GadgetReboot/Super_Mini_Mega_Tester/README.md

# Super_Mini_Mega_Tester
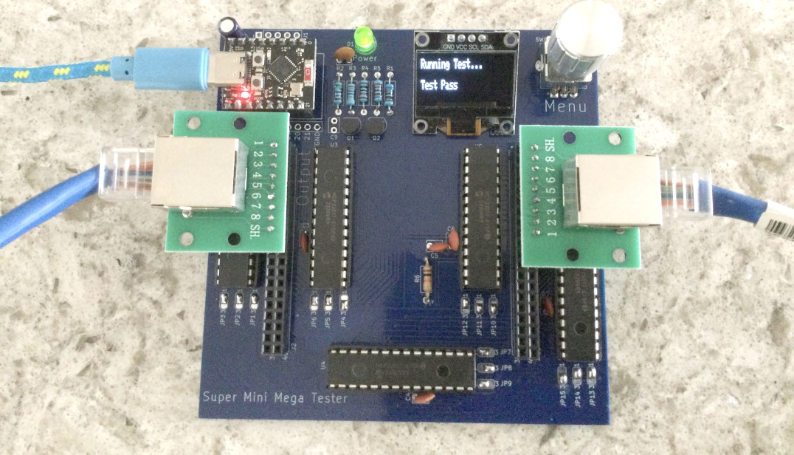
[picture p1: Assembled_PCB.jpg]
PCB
<br><br><BR><BR>
40 Pin Cable Tester platform using ESP32-C3 Super Mini module<BR><BR>
JP1 through JP15 jumpers must have solder jumpers blobbed on to set the addresses of the five GPIO expander ICs.
