GadgetReboot/Super_Mini_Mega_Tester/Sch_Super_Mini_Mega Tester.pdf

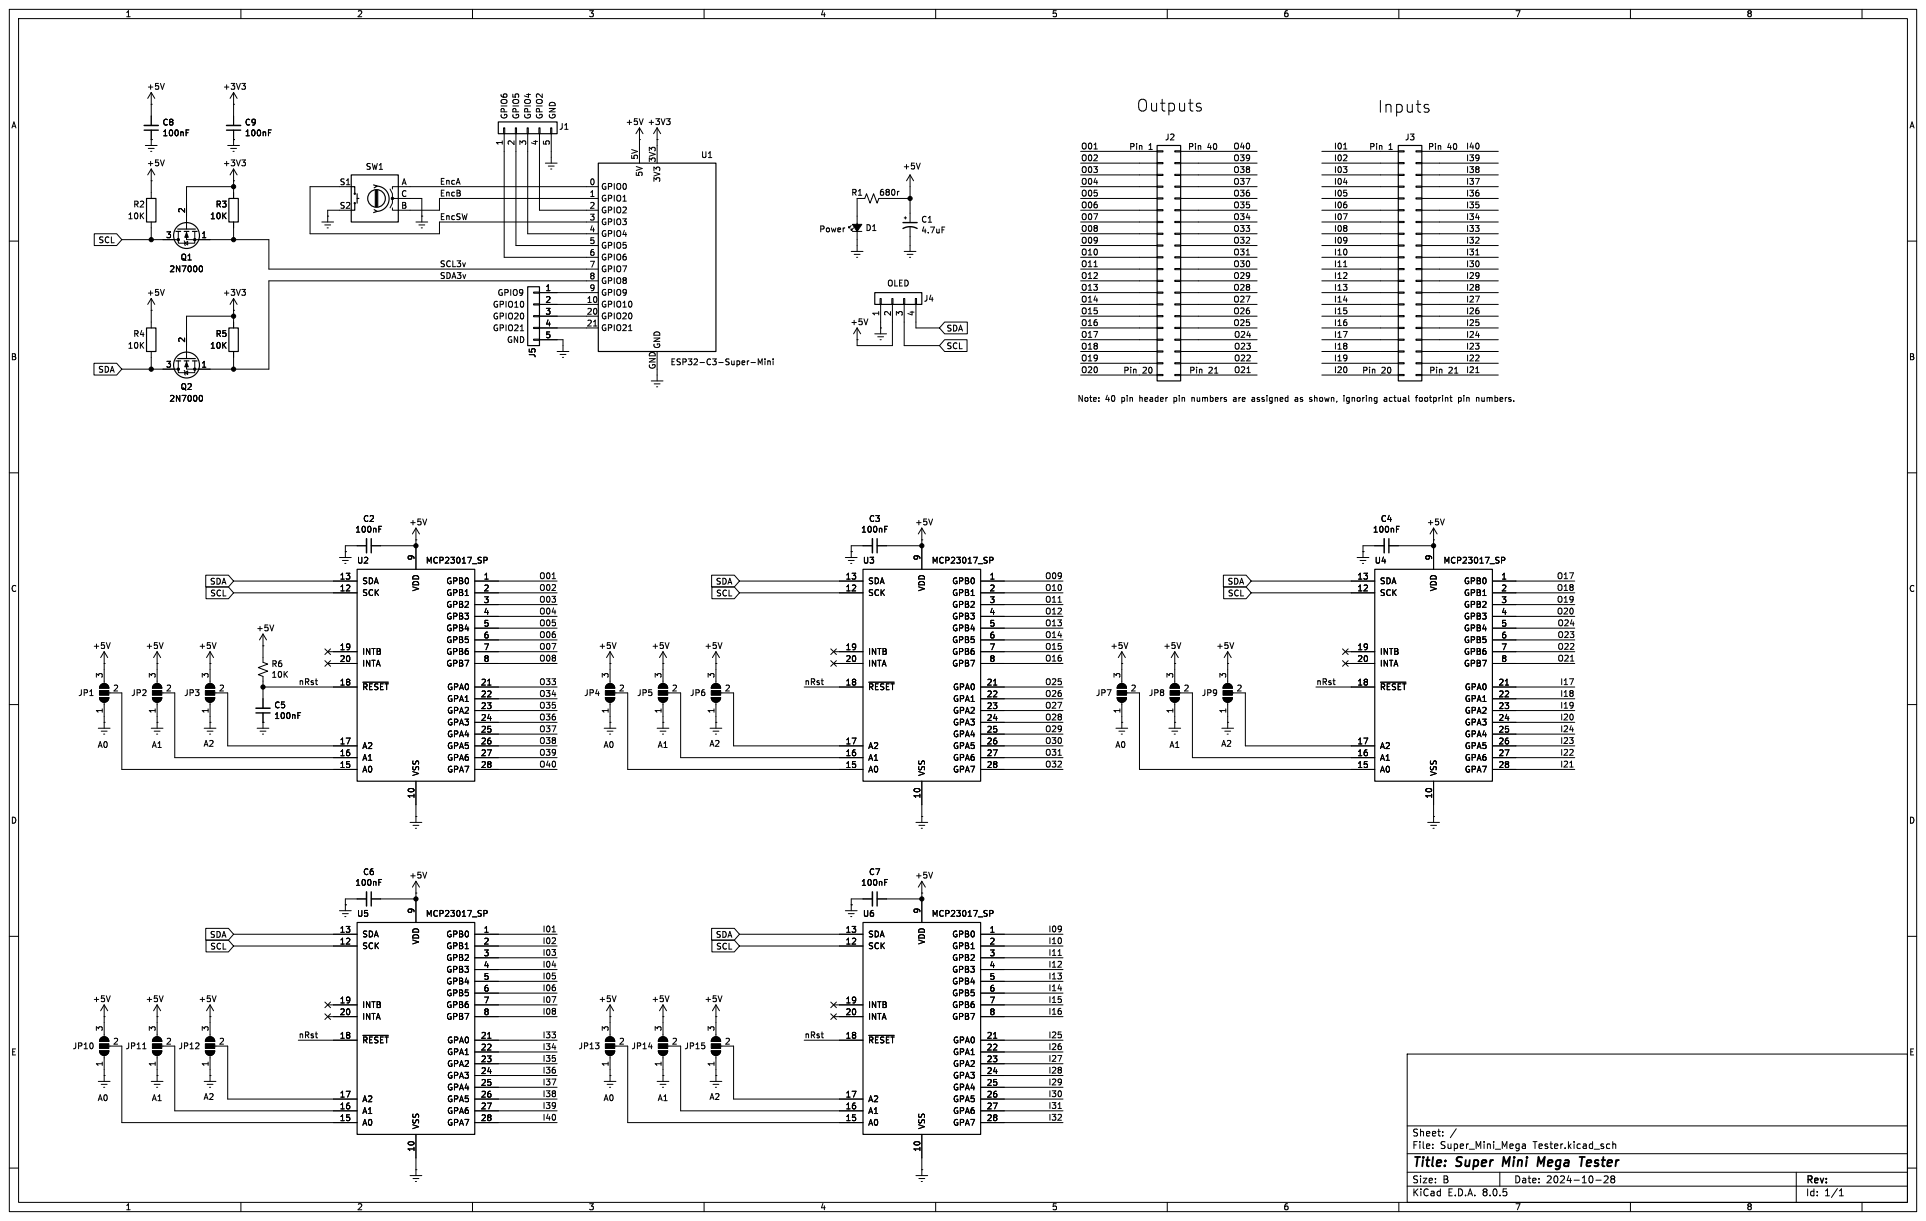
[picture p2: page 1]
