GadgetReboot/Super_Mini_Mega_Tester/KiCad/Super_Mini_Mega Tester.kicad_pcb

## KiCad design KiCad/Super_Mini_Mega Tester.kicad_pcb (2024-11-19)

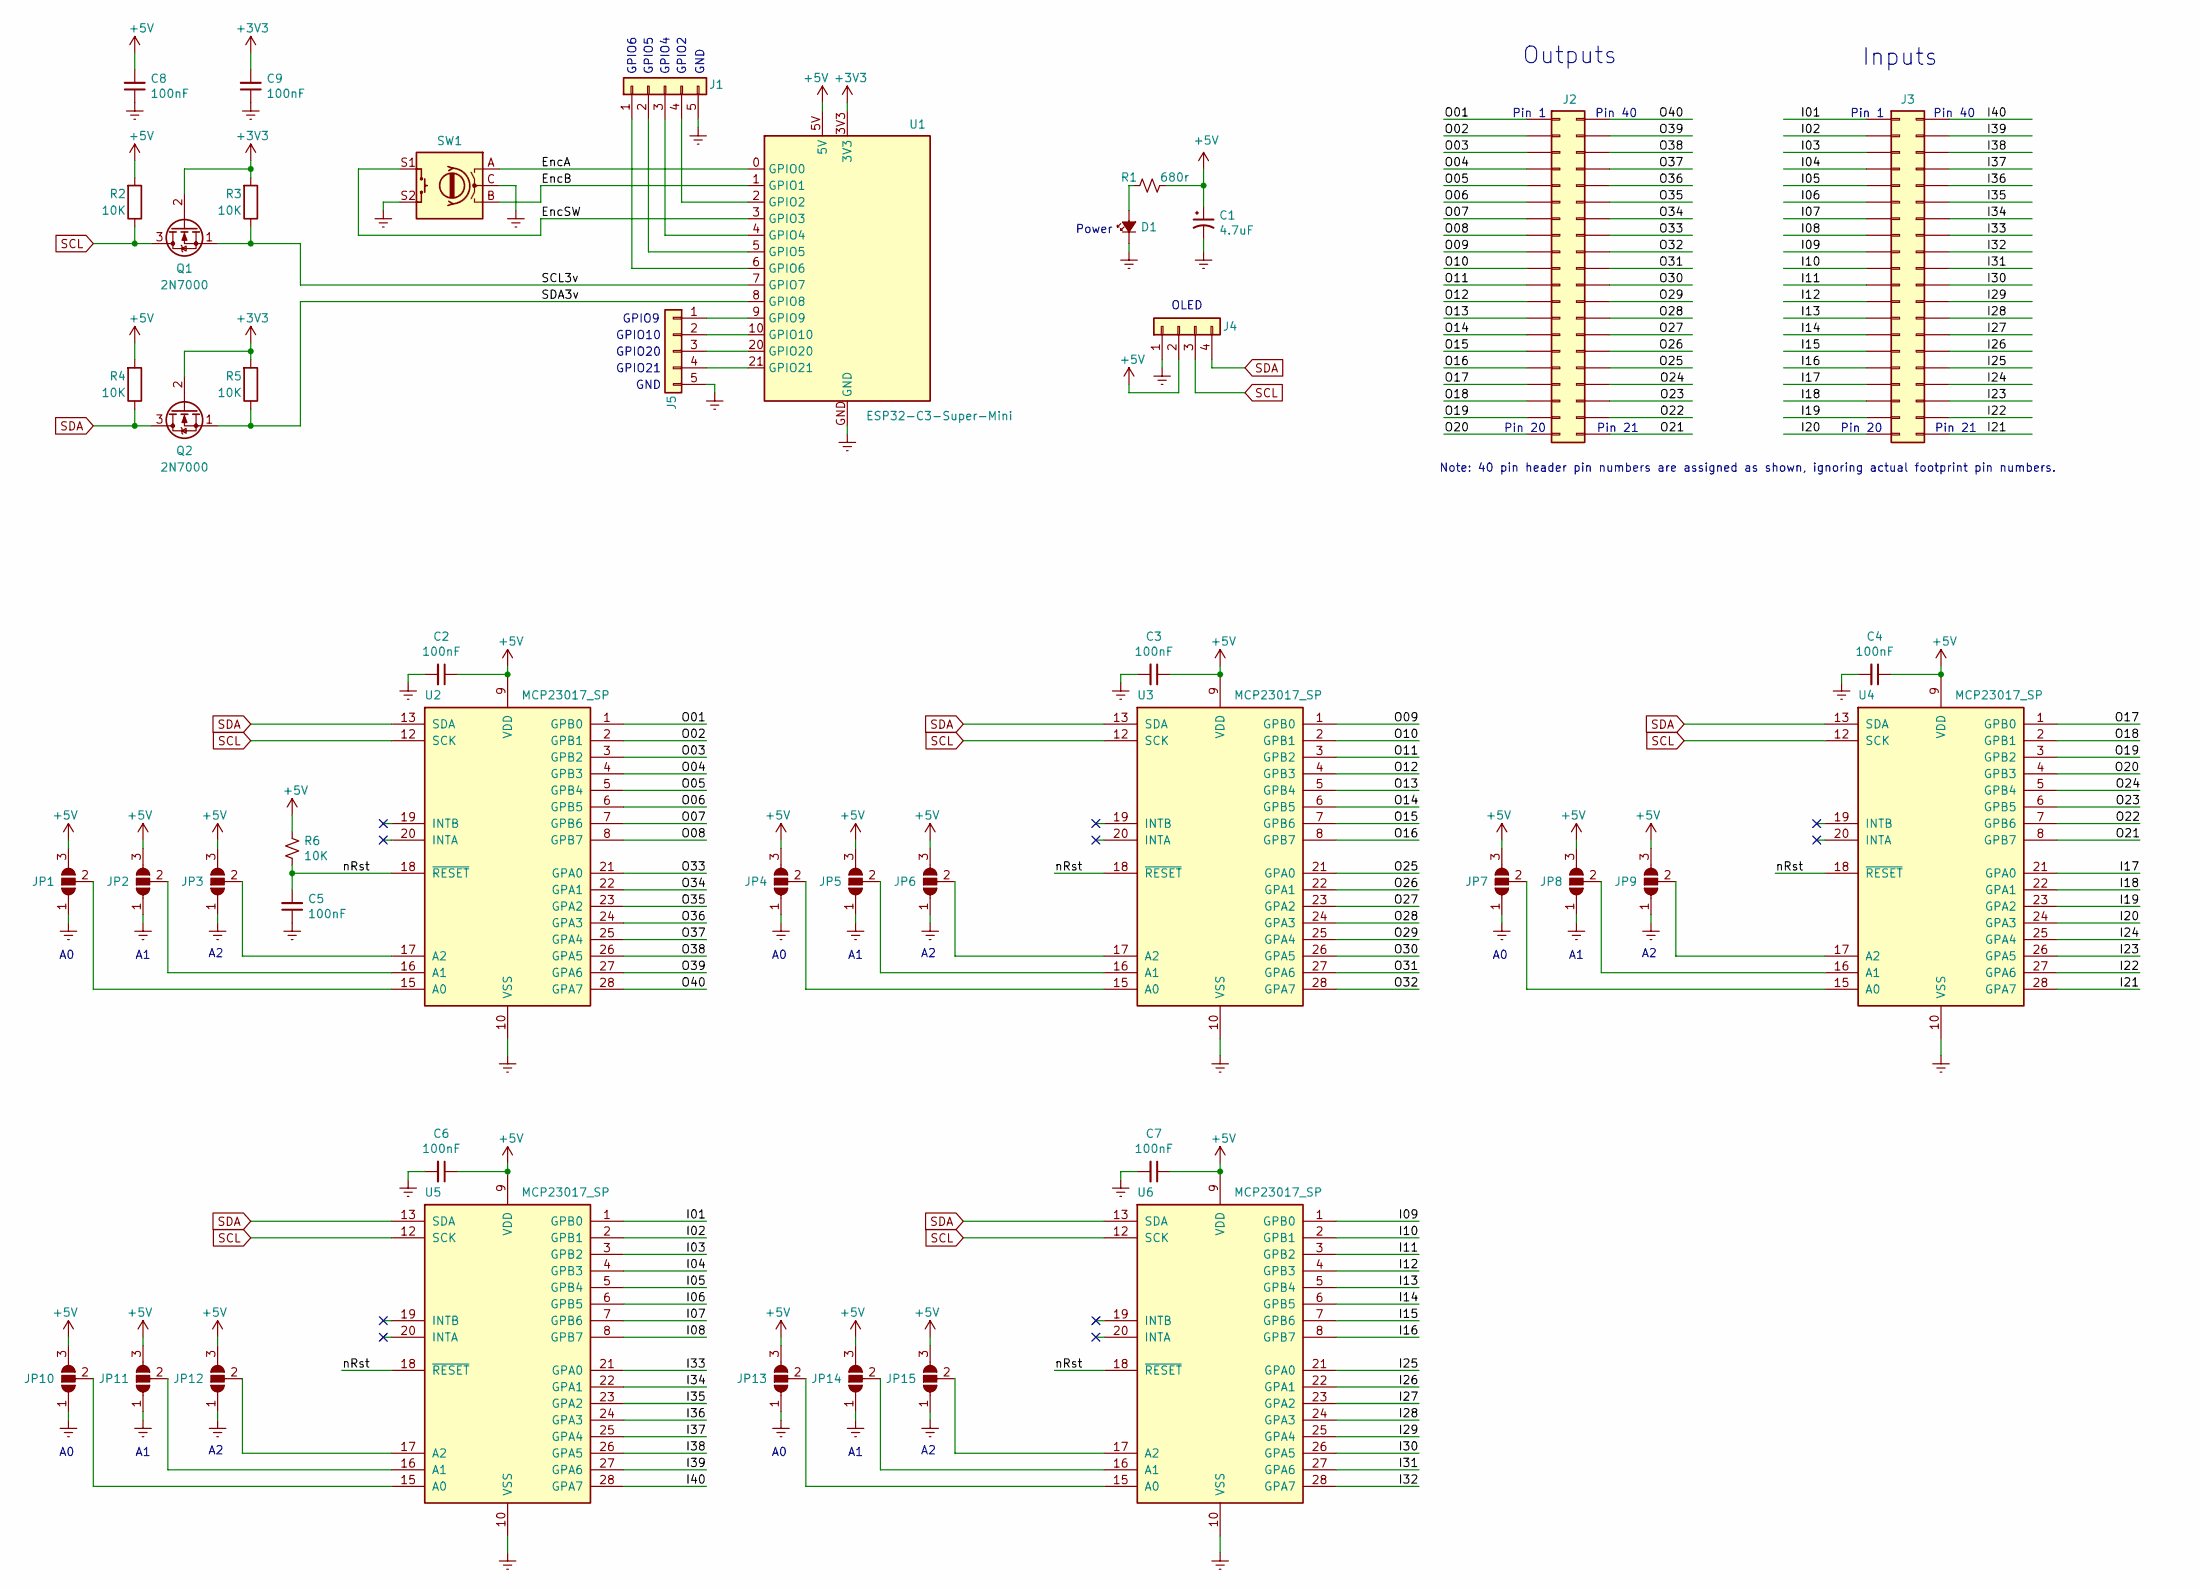
[picture p3: schematic Super_Mini_Mega Tester.kicad_sch, Super Mini Mega Tester]

Parts:
C1: 4.7uF; CP_Radial_D5.0mm_P2.50mm
C2, C3, C4, C5, C6, C7, C8, C9: 100nF; C_Disc_D3.8mm_W2.6mm_P2.50mm
D1: LED_Small_ALT; LED_D5.0mm
J1, J5: Conn_01x05; PinHeader_1x05_P2.54mm_Vertical
J2, J3: Conn_02x20_Odd_Even; PinHeader_2x20_P2.54mm_Vertical
J4: Conn_01x04; PinHeader_1x04_P2.54mm_Vertical
JP1, JP2, JP3, JP4, JP5, JP6, JP7, JP8, JP9, JP10, JP11, JP12, JP13, JP14, JP15: SolderJumper_3_Open; SolderJumper-3_P1.3mm_Open_RoundedPad1.0x1.5mm_NumberLabels
Q1, Q2: 2N7000; TO-92_Inline
R1: 680r; R_Axial_DIN0207_L6.3mm_D2.5mm_P10.16mm_Horizontal
R2, R3, R4, R5, R6: 10K; R_Axial_DIN0207_L6.3mm_D2.5mm_P10.16mm_Horizontal
SW1: RotaryEncoder_Switch; RotaryEncoder_Alps_EC11E-Switch_Vertical_H20mm_CircularMoun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
U1: ESP32-C3-Super-Mini; ESP32C3_Super_Mini
U2, U3, U4, U5, U6: MCP23017_SP; DIP-28_W7.62mm

Connections:
+3V3: C9.2, Q1.2 (G), Q2.2 (G), R3.2, R5.2, U1.3V3
+5V: C1.1, C2.1, C3.1, C4.1, C6.1, C7.1, C8.2, J4.2, JP1.3 (B), JP2.3 (B), JP3.3 (B), JP4.3 (B), JP5.3 (B), JP6.3 (B), JP7.3 (B), JP8.3 (B), JP9.3 (B), JP10.3 (B), JP11.3 (B), JP12.3 (B), JP13.3 (B), JP14.3 (B), JP15.3 (B), R1.1, R2.2, R4.2, R6.1, U1.5V, U2.9 (VDD), U3.9 (VDD), U4.9 (VDD), U5.9 (VDD), U6.9 (VDD)
/EncA: SW1.A, U1.0 (GPIO0)
/EncB: SW1.B, U1.1 (GPIO1)
/EncSW: SW1.S1, U1.3 (GPIO3)
/I01: J3.1, U5.1 (GPB0)
/I02: J3.3, U5.2 (GPB1)
/I03: J3.5, U5.3 (GPB2)
/I04: J3.7, U5.4 (GPB3)
/I05: J3.9, U5.5 (GPB4)
/I06: J3.11, U5.6 (GPB5)
/I07: J3.13, U5.7 (GPB6)
/I08: J3.15, U5.8 (GPB7)
/I09: J3.17, U6.1 (GPB0)
/I10: J3.19, U6.2 (GPB1)
/I11: J3.21, U6.3 (GPB2)
/I12: J3.23, U6.4 (GPB3)
/I13: J3.25, U6.5 (GPB4)
/I14: J3.27, U6.6 (GPB5)
/I15: J3.29, U6.7 (GPB6)
/I16: J3.31, U6.8 (GPB7)
/I17: J3.33, U4.21 (GPA0)
/I18: J3.35, U4.22 (GPA1)
/I19: J3.37, U4.23 (GPA2)
/I20: J3.39, U4.24 (GPA3)
/I21: J3.40, U4.28 (GPA7)
/I22: J3.38, U4.27 (GPA6)
/I23: J3.36, U4.26 (GPA5)
/I24: J3.34, U4.25 (GPA4)
/I25: J3.32, U6.21 (GPA0)
/I26: J3.30, U6.22 (GPA1)
/I27: J3.28, U6.23 (GPA2)
/I28: J3.26, U6.24 (GPA3)
/I29: J3.24, U6.25 (GPA4)
/I30: J3.22, U6.26 (GPA5)
/I31: J3.20, U6.27 (GPA6)
/I32: J3.18, U6.28 (GPA7)
/I33: J3.16, U5.21 (GPA0)
/I34: J3.14, U5.22 (GPA1)
/I35: J3.12, U5.23 (GPA2)
/I36: J3.10, U5.24 (GPA3)
/I37: J3.8, U5.25 (GPA4)
/I38: J3.6, U5.26 (GPA5)
/I39: J3.4, U5.27 (GPA6)
/I40: J3.2, U5.28 (GPA7)
/O01: J2.1, U2.1 (GPB0)
/O02: J2.3, U2.2 (GPB1)
/O03: J2.5, U2.3 (GPB2)
/O04: J2.7, U2.4 (GPB3)
/O05: J2.9, U2.5 (GPB4)
/O06: J2.11, U2.6 (GPB5)
/O07: J2.13, U2.7 (GPB6)
/O08: J2.15, U2.8 (GPB7)
/O09: J2.17, U3.1 (GPB0)
/O10: J2.19, U3.2 (GPB1)
/O11: J2.21, U3.3 (GPB2)
/O12: J2.23, U3.4 (GPB3)
/O13: J2.25, U3.5 (GPB4)
/O14: J2.27, U3.6 (GPB5)
/O15: J2.29, U3.7 (GPB6)
/O16: J2.31, U3.8 (GPB7)
/O17: J2.33, U4.1 (GPB0)
/O18: J2.35, U4.2 (GPB1)
/O19: J2.37, U4.3 (GPB2)
/O20: J2.39, U4.4 (GPB3)
/O21: J2.40, U4.8 (GPB7)
/O22: J2.38, U4.7 (GPB6)
/O23: J2.36, U4.6 (GPB5)
/O24: J2.34, U4.5 (GPB4)
/O25: J2.32, U3.21 (GPA0)
/O26: J2.30, U3.22 (GPA1)
/O27: J2.28, U3.23 (GPA2)
/O28: J2.26, U3.24 (GPA3)
/O29: J2.24, U3.25 (GPA4)
/O30: J2.22, U3.26 (GPA5)
/O31: J2.20, U3.27 (GPA6)
/O32: J2.18, U3.28 (GPA7)
/O33: J2.16, U2.21 (GPA0)
/O34: J2.14, U2.22 (GPA1)
/O35: J2.12, U2.23 (GPA2)
/O36: J2.10, U2.24 (GPA3)
/O37: J2.8, U2.25 (GPA4)
/O38: J2.6, U2.26 (GPA5)
/O39: J2.4, U2.27 (GPA6)
/O40: J2.2, U2.28 (GPA7)
/SCL3v: Q1.1 (S), R3.1, U1.7 (GPIO7)
/SDA3v: Q2.1 (S), R5.1, U1.8 (GPIO8)
/nRst: C5.2, R6.2, U2.18 (~RESET), U3.18 (~RESET), U4.18 (~RESET), U5.18 (~RESET), U6.18 (~RESET)
GNDREF: C1.2, C2.2, C3.2, C4.2, C5.1, C6.2, C7.2, C8.1, C9.1, D1.1 (K), J1.5, J4.1, J5.5, JP1.1 (A), JP2.1 (A), JP3.1 (A), JP4.1 (A), JP5.1 (A), JP6.1 (A), JP7.1 (A), JP8.1 (A), JP9.1 (A), JP10.1 (A), JP11.1 (A), JP12.1 (A), JP13.1 (A), JP14.1 (A), JP15.1 (A), SW1.C, SW1.S2, U1.GND, U2.10 (VSS), U3.10 (VSS), U4.10 (VSS), U5.10 (VSS), U6.10 (VSS)
unnamed: D1.2 (A), R1.2
unnamed: J1.1, U1.6 (GPIO6)
unnamed: J1.2, U1.5 (GPIO5)
unnamed: J1.3, U1.4 (GPIO4)
unnamed: J1.4, U1.2 (GPIO2)
unnamed: J5.1, U1.9 (GPIO9)
unnamed: J5.2, U1.10 (GPIO10)
unnamed: J5.3, U1.20 (GPIO20)
unnamed: J5.4, U1.21 (GPIO21)
unnamed: JP1.2 (C), U2.15 (A0)
unnamed: JP2.2 (C), U2.16 (A1)
unnamed: JP3.2 (C), U2.17 (A2)
unnamed: JP4.2 (C), U3.15 (A0)
unnamed: JP5.2 (C), U3.16 (A1)
unnamed: JP6.2 (C), U3.17 (A2)
unnamed: JP7.2 (C), U4.15 (A0)
unnamed: JP8.2 (C), U4.16 (A1)
unnamed: JP9.2 (C), U4.17 (A2)
unnamed: JP10.2 (C), U5.15 (A0)
unnamed: JP11.2 (C), U5.16 (A1)
unnamed: JP12.2 (C), U5.17 (A2)
unnamed: JP13.2 (C), U6.15 (A0)
unnamed: JP14.2 (C), U6.16 (A1)
unnamed: JP15.2 (C), U6.17 (A2)
SCL: J4.3, Q1.3 (D), R2.1, U2.12 (SCK), U3.12 (SCK), U4.12 (SCK), U5.12 (SCK), U6.12 (SCK)
SDA: J4.4, Q2.3 (D), R4.1, U2.13 (SDA), U3.13 (SDA), U4.13 (SDA), U5.13 (SDA), U6.13 (SDA)

Notes on the sheet:
OLED
GPIO4
GND
Pin 20
GPIO21
Pin 21
GPIO9
GPIO10
Pin 40
Note: 40 pin header pin numbers are assigned as shown, ignoring actual footprint pin numbers.
GPIO6
Inputs
GPIO5
Pin 1
GPIO2
Power
GPIO20
Outputs

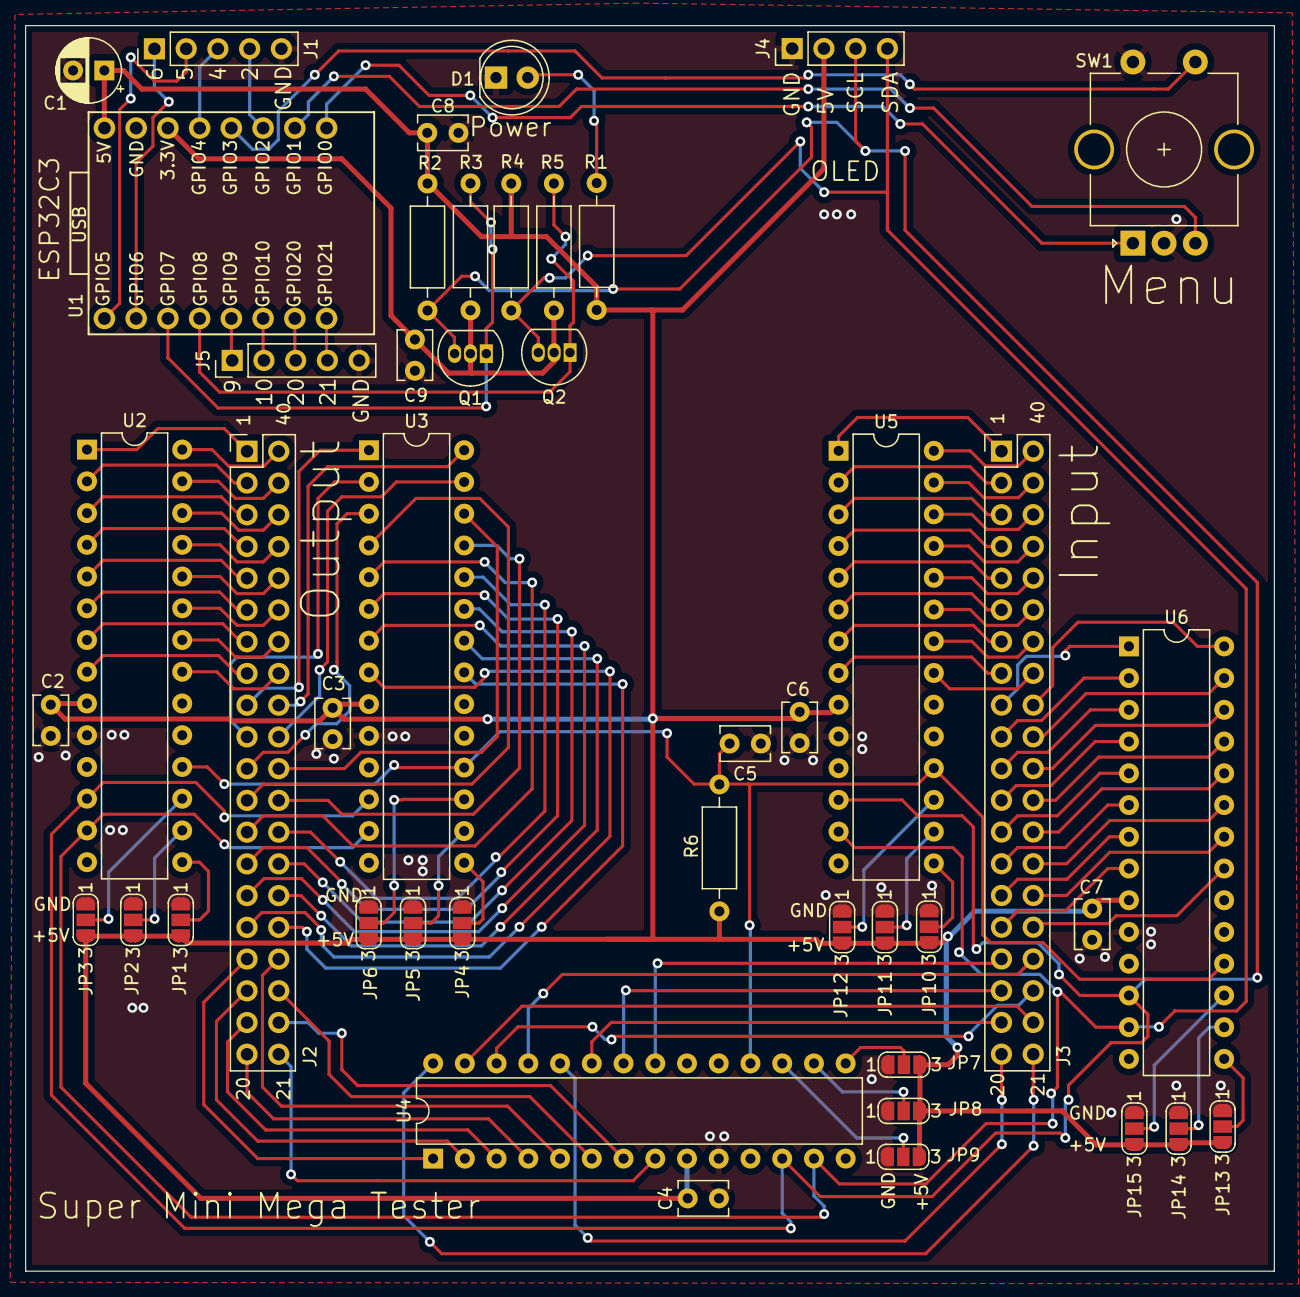
[picture p4: board Super_Mini_Mega Tester.kicad_pcb from above]

Board: 2 copper layers, 99.9 x 99.7 mm, 45 parts (0 on the bottom side), 115 nets.
